TeamPracticalProjects/LoRa_experiments/(threads)

Thread 14 (2024-08-10):

ENH: Cleaner Serial I/O code

BobGlicksman, 2024-08-10:
Utility code in tpp_LoRa.cpp utilizes the available() method and self-implemented timers to timeout serial I/O communications.  There is nothing wrong with this approach.  However, the Serial I/O library has these features built-in and the code could be cleaned up accordingly.  Specifically, Serial.readString() reads in a string from the serial I/O port.  The readString() method has an automatic timeout on it and will return whatever is in the serial buffer (including nothing) when it times out.  The default timeout is 1 second (1000 ms).  However, this can be changed by using the setTimeout() method.  The argument to setTimeout() is a number of milliseconds for the timeout, i.e. Serial.setTimeout(10) sets a 10 ms timeout for the readString() method on the Serial port.

In addition to readString, the library has another method called readStringUntil().  The argument is a char -- the character that will terminate the read and return the string when it is detected.  If the termination character is not received within the timeout period, the string will be returned upon timeout.

Reference:  https://www.arduino.cc/reference/en/language/functions/communication/serial/

Thread 27 (2024-11-15):

ENH: Burn ATmega code from within Visual Studio Code

jschrempp, 2024-11-15:
It would be great to get away from the Arduino IDE. I don't know if this is possible.

BobGlicksman, 2024-11-15:
I don't know either - particularly the way that we are flashing code to bare bones chips via SPI lines.  We would have to figure out what calls to avrdude are being made and what other configuration information is needed in order to flash the code from a command line (or integrate with VSCode).

Thread 29 (2024-11-15):

ENH: Speed sensing the LoRa

jschrempp, 2024-11-15:
On boot the Hub code will try communicating with the LoRa at 38,400. If it gets a bad response, then it will try at 115200. This will allow the hub to handle both LoRa devices used in the hub and factory new devices.

BobGlicksman, 2024-11-15:
I think that this is a good idea, or else just leave hub LoRa modules at the default baud rate and only change the sensor board rate.

Thread 30 (2024-11-15):

ENH: Set LoRa speed to 38400 - make this our standard

jschrempp, 2024-11-15:
If during boot the hub is successful in communicating to the LoRa at 115200, then it will set the LoRa baud rate to 38400. The hub will then reboot.

Doing this will allow the hub to accept a factory new LoRa device and configure it so it will work in the ATmega sensor.

Having 38400 as our standard will not significantly impact the hub - or any Particle device - and remove one part of the complexity of our system.

Closed 2025-07-25.

Thread 32 (2024-11-15):

ENH: Pick one repo location for Hub / Sensor

jschrempp, 2024-11-15:
Decide how we will work going forward, now that we have finished the experimentation phase.

We share one code location for the Hub since it runs on Particle processors.

For the sensor, do we need a location for Particle and one for ATmega? Or can we have one code base with a #define for the target hardware? Eventually we might have one code base for each sensor type (reed switches, PIRs, temperature probes, critical sensors, etc). If each one has to have both a Particle and ATmega folder, that will become a lot of folders.

Thread 36 (2024-11-18):

ENH:  use String method reserve() to allocate a memory buffer for strings

BobGlicksman, 2024-11-18:
We are heavily using the String() class in our code, including to build strings.  Strings are memory hogs and the ATMega328 has only 2K of RAM.  It is possible that code that runs fine on a Photon (20K or more of RAM) will run out of RAM when ported over to the ATMega328, causing unpredictable execution errors.  I cannot find any documentation about the default character buffer size that String uses, but we can calculate a maximum size the won't create holes in the heap when we build strings, leading to memory leakage and unpredictable crashes,

According to Arduino/Particle documentation, the String() buffer is allocated on the heap.  As far as I know, there is no garbage collector (this is C, after all).  If, in the course of building a string, the default buffer is exceeded, String() will likely allocate a new, larger buffer on the heap and may or may not clean up the old buffer to recover RAM (since it is the heap, recovery of memory means wholesale movement of the contents of the heap, which I think unlikely for code included in String() ).  By using the reserve() method, we can force the declared Sting object to have a large enough buffer so that the entire built-up string has enough buffer space and thereby avoid memory leaks that might crash the ATMega328.

Needless to say, we should strictly limit the number of String() variables that we declare, as each such variable will have its own buffer, thus eating up RAM.

Our code has a lot of hidden String variables -- string building within if() statements, etc that presumably result in new string buffers being created on the fly.  It is unclear if these temporary string buffers are allocated on the stack or the heap.  Perhaps declaring a String() variable and reusing it in these instances may save RAM and prevent memory fragmentation and leakage.

An alternative to all of this is to avoid the String() class altogether and declare our own character buffer and use C-style string functions to do the string building and string parsing.

BobGlicksman, 2024-11-18:
Here is a good tutorial:
https://www.instructables.com/Taming-Arduino-Strings-How-to-Avoid-Memory-Issues/

Closed 2024-12-24.

Thread 37 (2024-11-18):

ENH: clean up serial.readString() useage.

BobGlicksman, 2024-11-18:
Our current code contains a legacy of past misunderstanding of the readString() method of the Serial class.  In particular, we have delays() in the code to ensure that the entire message is read.  There are also non-blocking timeouts in the code that ensure that we have read in the entire string. All of these are unnecessary.  Here is how readString() works:

1.  available() must be used first to ensure that there is at least one character in the serial buffer - the incoming message has started.
2. readString() then reads in characters from the buffer until the buffer is empty for longer than the Serial.timeout() parameter.  Once there are no more characters to read after the timeout(), readString() returns (with the number of characters read).
3. the default timeout() is 1 second, which is way too long.  However, once Serial() objects are declared, Serial.timeout(x) will set the timeout to "x" milliseconds.  For our case, Serial.timeout(10) will be quite adequate.

Since Serial.readString() is guaranteed to terminate using it's own, internal timeout, and since no string that we receive will have space between characters of > 10 ms, we can clean up all of our own timeout and delay() code.

Closed 2024-12-24.

Thread 39 (2024-12-02):

ENH: Add header to allow programming ATmega

jschrempp, 2024-12-02:
There are 4 lines between the Arduino programmer and the ATmega. If we had a header for those 4 on the PCB, then we could make a cable and program the ATmega while it is in place on the PCB.

BobGlicksman, 2024-12-03:
We already have the pins brought out to header fields on the current PCB.  Unfortunately, the UNO is 5 volts and we are limited to 3.3 volts on the development board because of the LoRa module.  Therefore, we cannot hook up an Uno to our PCB.  We will have to continue to remove the ATmega chip from the 3 volt PCB and place it into a 5 volt programmer setup in order for this to work.

jschrempp, 2024-12-04:
I wonder if we could jumper out the LoRa module power so that we could program on the board. Maybe a jumper that in one position powers the LoRa module, but in the other position jumpers offboard power to the rest of the hardware.

BobGlicksman, 2024-12-04:
I'm sure that we could do something along these lines, but why?  When we wanted to program the microcontroller we would need to remove this jumper, and perhaps one on the reset line as well, and of  course disconnect the 3 volt battery,  then connect up 6 wires from the Arduino, and after programming, we would need to remember to remove the wires from the Arduino (or at least the Arduino power) and replace the jumper(s) - and in order, or else we would short the +5 volt supply to the battery and/or connect the LoRa module to +5 and possibly damage it, etc. etc.  And, all of this to avoid popping the microcontroller out of one zif socket and into another for programming?  I'm not sure I see any simplification here, and certainly I see less safety.

Closed 2024-12-24.

Thread 49 (2024-12-22):

ENH: add address jumpers to production sensor code

BobGlicksman, 2024-12-22:
The sensor test code has provision to set 3 jumpers that add a value (0-7) to a base address for a sensor.  We need to port this code into the production version of the sensor.  We need to do this for the Arduino version, but it would be best to support this functionality on the Photon version of the code as well.  To this latter end, we will need to select Photon (1 and 2) pins for these 3 address jumpers.

BobGlicksman, 2024-12-23:
Code is ported and tested in the production version for Arduino; need to test on Photon.  Note that on Photon, need to set the pin power to HIGH on the LED pins -- see the proposed pinout in another issue.

Closed 2024-12-24.

Thread 50 (2024-12-22):

ENH:  Add option to not wait for a response message to the production sensor code

BobGlicksman, 2024-12-22:
The current sensor code waits for an acknowledgement message from the hub before shutting down the sensor.  This adds around 1 seconds of high power draw time to each sensor trip.  In order the support the lowest power consumption in a simple door/gate/mailbox Arduino sensor that doesn't support processing the ack message anyway, we need a pre-compile OPTION to just send the sensor trip message and then immediately go back to deep sleep, without waiting for an ank from the hub.

Closed 2025-07-25.

Thread 51 (2024-12-22):

ENH:  Review and clean up large buffers

BobGlicksman, 2024-12-22:
The current (v 2.4) sensor code still reserves large buffers (100 characters each) in the lora class, as well as 75 character buffers in the main code.  It would be best to review and minimize message sizes (to conserver power) and to reduce these buffers accordingly.  It would also be best to consolidate buffers between the main code and the class code by passing in references.  NOTE: this enhancement is a LOW PRIORITY as the code works on an ATMega328 as-is, and there appears to be sufficient headroom for functional enhancements to this code.  However, it would be best to skinny the production sensor code down as much as is feasible in order to provide maximum headroom for future feature enhancements.

Thread 53 (2024-12-22):

Photon 2 pin assignment conflicts

BobGlicksman, 2024-12-22:
It looks like the RED LED is assigned to Photon 2 pin D8, which is the Serial 1 Tx pin, so this is a conflict.  Also the GRN LED is assined to pin D7, which is also the internal LED.  We probably want the internal LED to operate seperately, so we should reassign this pin as well.  I guess that the debug LEDs aren't hooked up on a Photon 2 sensor breadboard, but we need to straighten out the pins assignments before a PCB can be laid out.

BobGlicksman, 2024-12-22:
Here is a proposal for connections on new PCBs for Photon 2 and for ATMega328:

PHOTON 2:
Wake-up interrupt pin = D10 (note: this is the wakeup pin from Hybernate mode - in case we want to experiment with this.)
Serial I/O Tx = Tx (D8) (note: this is the Serial 1 port)
Serial I/O Rx = Rx (D9) (note: this is the Serial 1 port)
Green LED Pin = D2
Red LED Pin = D3
ADR4 Pin = D6
ADR2 Pin = D5
ADR1 Pin = D4

ATMEGA328:
Wake-up interrupt pin = Arduino pin 2 (chip pin 4, INT0)
Serial I/O Tx = chip pin 3
Serial I/O Rx = chip pin 2
Green LED Pin = Arduino pin 9 (chip pin 15)
Red LED Pin = Arduino pin 8 (chip pin 14)
ADR4 Pin = Arduino pin 7 (chip pin 13)
ADR2 Pin = Arduino pin 6 (chip pin 12)
ADR1 Pin = Arduino pin 5 (chip pin 11)
Note: address pins are not available on the current PCB, so address will default to BASE + 7

BobGlicksman, 2024-12-23:
Reading further in the Photon 2 datasheet, it is not good to use D6, so here is a revised proposal for Photon 2 pin connections.

Also:  in order to drive LEDs, must use pinSetDriveStrength(pin, HIGH);  Use 330 ohm in series with LED to limit current to about 5 ma.  This applies to Green LED Pin and Red LED Pin, below.

PHOTON 2:
Wake-up interrupt pin = D10/WKP (note: this is the wakeup pin from Hybernate mode - in case we want to experiment with this.)
Serial I/O Tx = Tx (D8) (note: this is the Serial 1 port)
Serial I/O Rx = Rx (D9) (note: this is the Serial 1 port)
Green LED Pin = D2
Red LED Pin = S4/D19
ADR4 Pin = D5
ADR2 Pin = D4
ADR1 Pin = D3

BobGlicksman, 2025-01-26:
Tested these pins on Photon 2 sensor breadboard and they work.  Issue is closed.

BobGlicksman, 2025-01-26:
Tested these pins on Photon 2 sensor breadboard and they work. Issue is closed.

Closed 2025-01-26.

Thread 54 (2024-12-26):

ENH: add one retry if the lora module ever returns ERR (vs OK) to a command.

BobGlicksman, 2024-12-26:
The current production code check and times out the response from the LoRa module to commands sent by the host processor.  In the event of a timeout or an error, the firmware goes into an infinite loop with a specific pattern of LED flashes that indicate what and where the error was.  This happened only once during extensive stress testing and may have been mitigated by a weak battery.  Nevertheless, it might be advisible to perform one retry in this instance, allowing the sensor to (hopefully) keep working until the battert dies altogether.

Thread 61 (2025-02-28):

ENH:  Report and track door/gate state

BobGlicksman, 2025-02-28:
Modify the sensor code to detect if the door/gate was opened or closed and send an appropriate message.  Keep track of the current door/gate state (where?) and change it if a message is received indicating the opposite.  Here are some details:

SENSOR CODE:

1.  change the MODE parameter in attachInterrupt() in loop() from FALLING to CHANGE.  Note: it needs to be tested to verify that this works to wake up the microcontroller on both falling and rising edges.
2. Immediately when the microcontroller wakes up and before waking up the LoRa module, wait a few milliseconds (to debounce the sensor contact) and then read the interrupt pin (pin 2) to determine the current state of the contact sensor.
3. Proceed as normal to power up the LoRa module and send a message; but now there are two messages -- one says that the door/gate is closed and the other says that it is opened.
4. Waiting for a response from the hub and retrying sending the message if no response is received is a good idea in this application.

HUB/CLOUD:

1.  The Hub needs to process the received messages to determine which message (opened or closed) was received.
2.  OPTION 1:  The Hub keeps track of the current state of each door/gate.  The Hub compares the last stored state of the door/gate with the message type and if they are opposite, the Hub changes the persistent door/gate state per the message.
3. OPTION 2:  The Hub reposts the received message to the Google App Script.  The Google App Script reads the last stored state of the door/gate from the spreadsheet and compares with the message type. If they are opposite, the Google App Script changes the door/gate state in the spreadsheet.
4. With either option, the Hub issues a response message to the sensor.

BobGlicksman, 2025-02-28:
In retrospect, we don't need either option 1 or option 2.  We just need to log the received message.  This way, the last logged door/gate message will tell the user the current state.  So, the Hub code and the Script code do not need to change; only the Sensor code.

Thread 63 (2025-04-05):

BUG? Hub crashes about once every few weeks

BobGlicksman, 2025-04-05:
The Photon 2 based hub seems to crash once every few weeks.  The multicolor LED is on solid and not breathing.  The code appears to have crashed.  Resetting the Photon 2 clears the problem and restores proper operation.

This problem was not seen with a Photon 1 based hub, which suggests that it is a Particle OS/WiFi connection issue.  Photon 2's seem to have some WiFi issue in that they often flash red when trying to connect to the Internet via WiFi.  This latter issue is a known Particle issue.  What isn't known is whether a working (Internet connected) Photon 2 that crashes in this manner has crashed due to a Particle issue or whether we have a memory leak in the code that causes the crash.

The possibility of a memory leak should be investigated.  If found to be the cause of the crash, it should be corrected.  The likely culprit would be string handling and we would need to modify the code using the same techniques as for the sensor code.

If the issue is a Particle WiFi issue with Photon 2's, then we should raise the issue again with Particle.

BobGlicksman, 2025-04-10:
I just has a lockup after only a few days.  Since the time between lockups was so short, I am more inclined than ever to rule out a memory leak issue in our code, and more inclined to believe this to be a Particle WiFi related issue.

BobGlicksman, 2025-07-25:
Fixed using Particle OS 6.3.0.

Closed 2025-07-25.
